haevnEU/Embedded-Systems-2/doc/Devices/Aufbau.jpg

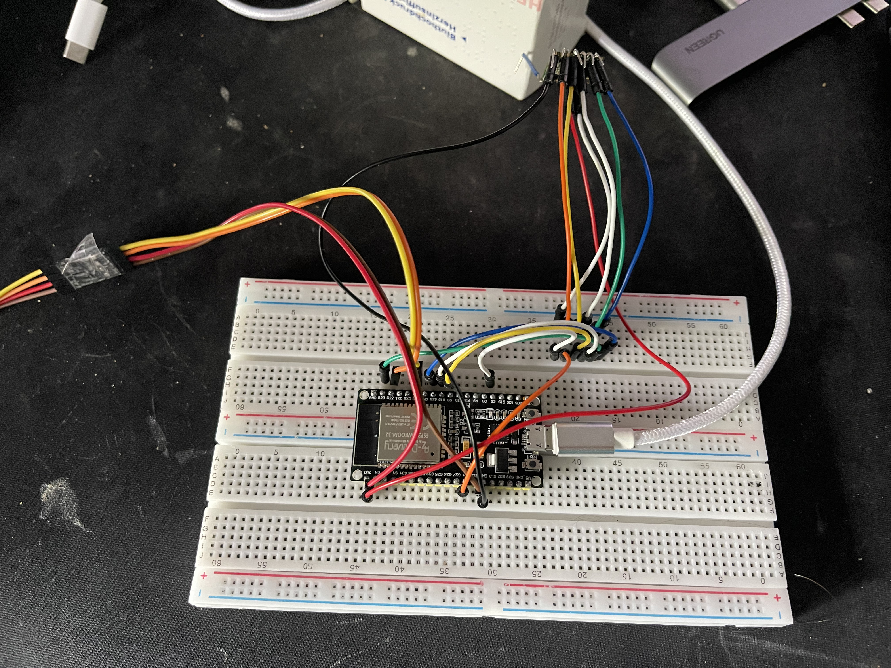
doc/Devices/Aufbau.jpg
