haevnEU/Embedded-Systems-2/doc/Devices/RFM95_LoRa_Funk_Transceiver.jpg

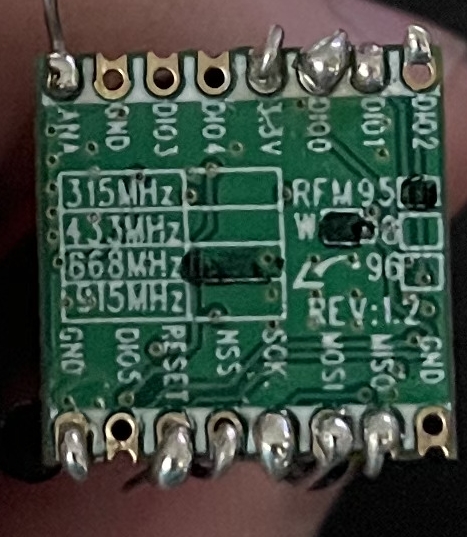
doc/Devices/RFM95_LoRa_Funk_Transceiver.jpg
