haevnEU/Embedded-Systems-2/README.md

# Embedded Systems II

Die Dokumentation kann im Verzeichniss `doc` eingesehen werden, [PDF Dokumentation](doc/Seminararbeit_Präsentation/Seminararbeit.pdf)
