haevnEU/Embedded-Systems-2/doc/Seminararbeit_Präsentation/ES2.pptx

## XiLab – Bewässerung mit IOT

Von Lars Dubrau, Nils Milewski, Alex Heiming

## Inhaltsübersicht

- Einführung
- Technologie Stack
- Demo
- Ausblick

## Einführung

- Bewässerung der Stadt umfangreich
- Heiße Sommer
- Interesse der Anwohner
- Einfache Bedienbarkeit

## Technologie Stack

- Website React
- REST API Backend Java
- Microcontroller C / C++

## Ausblick

- Website Erweiterung
- Erfahrung Testfeld
- Auswahl Hardware
