haevnEU/Embedded-Systems-2/doc/Devices/antenna_schema.png

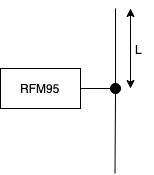
doc/Devices/antenna_schema.png
