haevnEU/Embedded-Systems-2/doc/Devices/RFM95_LoRa_Funk_Transceiver_schema.png

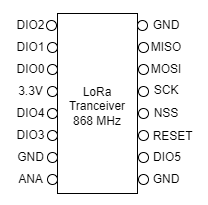
doc/Devices/RFM95_LoRa_Funk_Transceiver_schema.png
