haevnEU/Embedded-Systems-2/doc/Devices/VL53L0X_schema.png

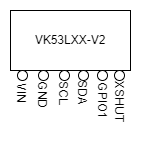
doc/Devices/VL53L0X_schema.png
