haevnEU/Embedded-Systems-2/doc/STL Dateien/Gehaeuse.stl

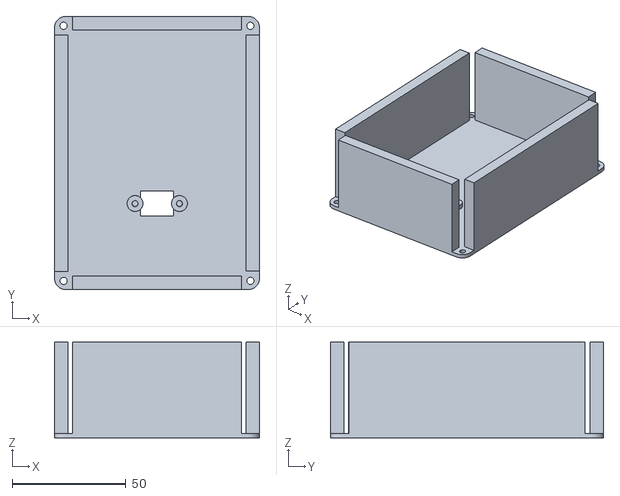
[picture p24: CAD file, 2023-11-06]
doc/STL Dateien/Gehaeuse.stl
90.0 x 120.0 x 42.0
