haevnEU/Embedded-Systems-2/Backend/xilab/src/main/java/de/hrw/xilab/spring/config/SecurityConfiguration.java

package de.hrw.xilab.spring.config;

import com.nimbusds.jose.jwk.JWK;
import com.nimbusds.jose.jwk.JWKSet;
import com.nimbusds.jose.jwk.RSAKey;
import com.nimbusds.jose.jwk.source.ImmutableJWKSet;
import com.nimbusds.jose.jwk.source.JWKSource;
import com.nimbusds.jose.proc.SecurityContext;
import org.springframework.beans.factory.annotation.Value;
import org.springframework.context.annotation.Bean;
import org.springframework.context.annotation.Configuration;
import org.springframework.security.config.Customizer;
import org.springframework.security.config.annotation.web.builders.HttpSecurity;
import org.springframework.security.config.annotation.web.configuration.EnableWebSecurity;
import org.springframework.security.config.annotation.web.configurers.oauth2.server.resource.OAuth2ResourceServerConfigurer;
import org.springframework.security.config.http.SessionCreationPolicy;
import org.springframework.security.core.userdetails.User;
import org.springframework.security.oauth2.jwt.JwtDecoder;
import org.springframework.security.oauth2.jwt.JwtEncoder;
import org.springframework.security.oauth2.jwt.NimbusJwtDecoder;
import org.springframework.security.oauth2.jwt.NimbusJwtEncoder;
import org.springframework.security.provisioning.InMemoryUserDetailsManager;
import org.springframework.security.web.SecurityFilterChain;

@Configuration
@EnableWebSecurity
public class SecurityConfiguration {

    private final RsaKeyProperties rsaKeys;

    @Value("${security.user}")
    private String user;

    @Value("${security.password}")
    private String password;
    public SecurityConfiguration(RsaKeyProperties rsaKeys) {
        this.rsaKeys = rsaKeys;
    }

    @Bean
    public SecurityFilterChain securityFilterChain(HttpSecurity http) throws Exception {
        return http
                .csrf(csrf -> csrf.disable())
                .cors().and()
                .authorizeRequests(request -> request
                        .mvcMatchers("/admin/**").authenticated()
                        .mvcMatchers("/device/**").permitAll()
                        .mvcMatchers("/code/**").permitAll()
                        .mvcMatchers("/token/**").permitAll())
                .oauth2ResourceServer(OAuth2ResourceServerConfigurer::jwt)
                .sessionManagement(session -> session.sessionCreationPolicy(SessionCreationPolicy.STATELESS))
                .httpBasic(Customizer.withDefaults())
                .build();
    }

    @Bean
    public JwtDecoder jwtDecoder() {
        return NimbusJwtDecoder.withPublicKey(rsaKeys.publicKey()).build();
    }

    @Bean
    public InMemoryUserDetailsManager user() {
        return new InMemoryUserDetailsManager(
                User.withUsername(user)
                        .password(password)
                        .authorities("write")
                        .build());
    }

    @Bean
    public JwtEncoder jwtEncoder() {
        JWK jwk = new RSAKey.Builder(rsaKeys.publicKey()).privateKey(rsaKeys.privateKey()).build();
        JWKSource<SecurityContext> jwks = new ImmutableJWKSet<>(new JWKSet(jwk));
        return new NimbusJwtEncoder(jwks);
    }
}
