haevnEU/Embedded-Systems-2/(commit log)

2022-10-11 Merged repository into this one
    [configuration.h]
2023-11-06 Upload dokumentation und Frontend
    [Gehaeuse.stl, Halterung.stl, configuration.h]
